arturo182/feather_mimxrt1011/schematics.pdf

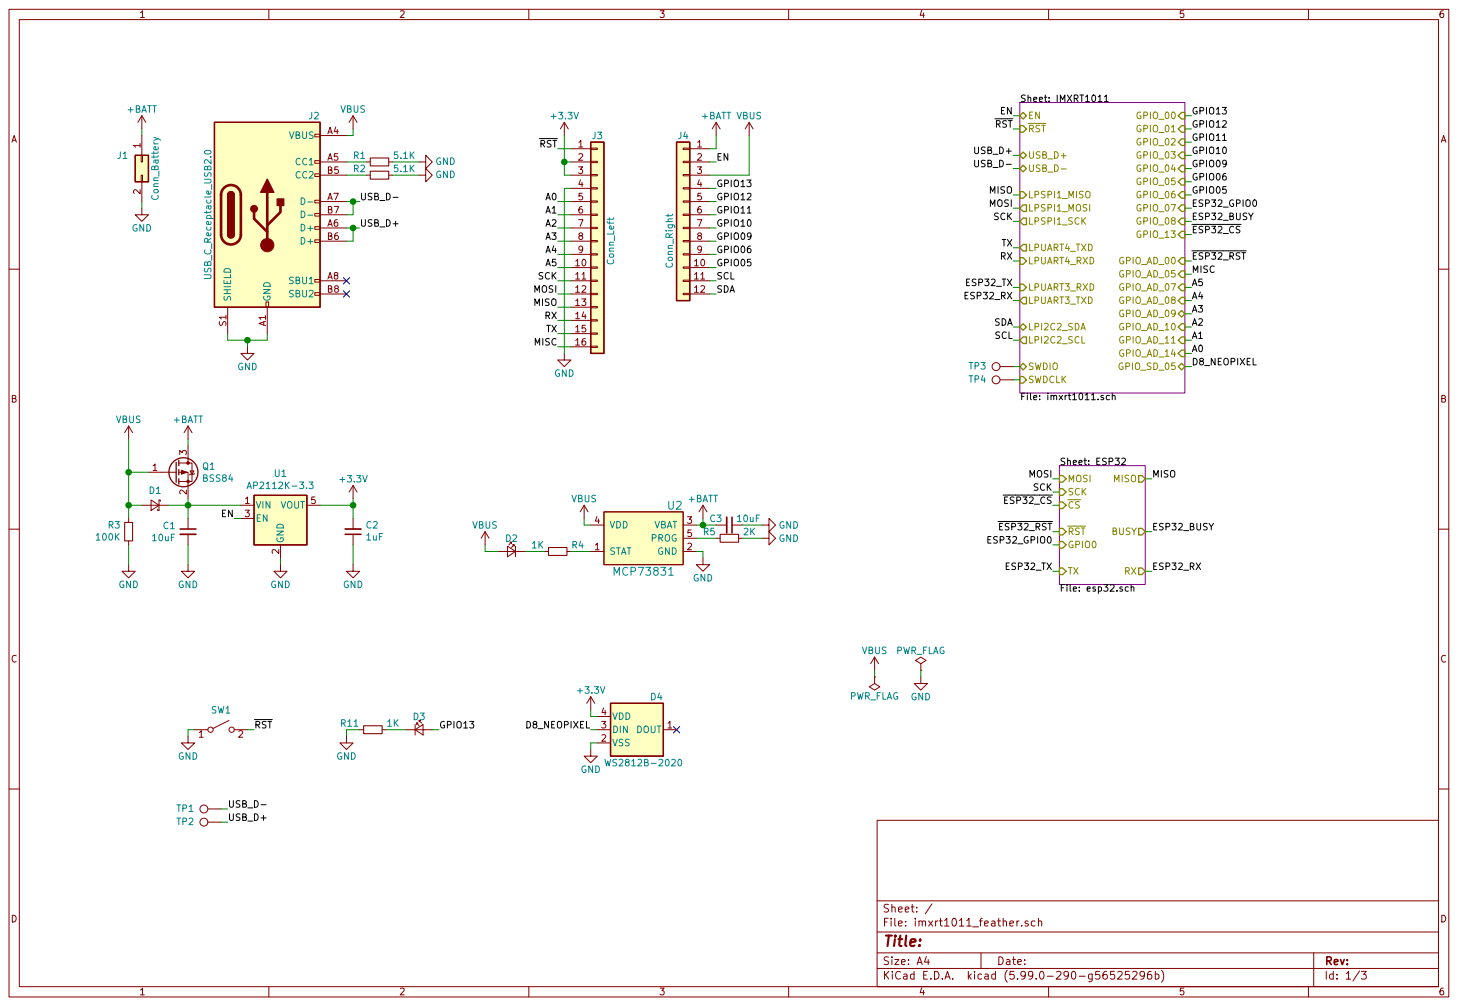
[picture p1: page 1]

ESP32_TX MOSI Sheet: IMXRT1011 File: imxrt1011.sch EN
RST USB_D- USB_D+

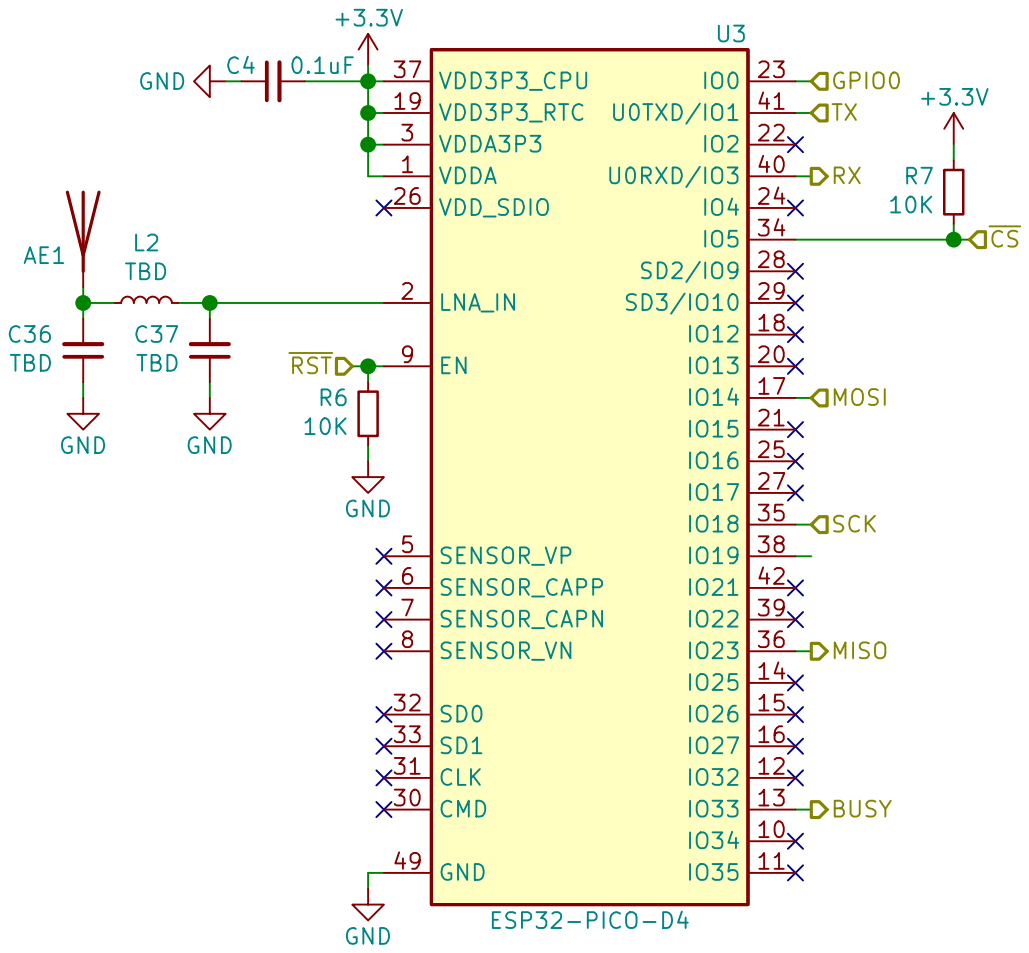
[picture p2: page 2]

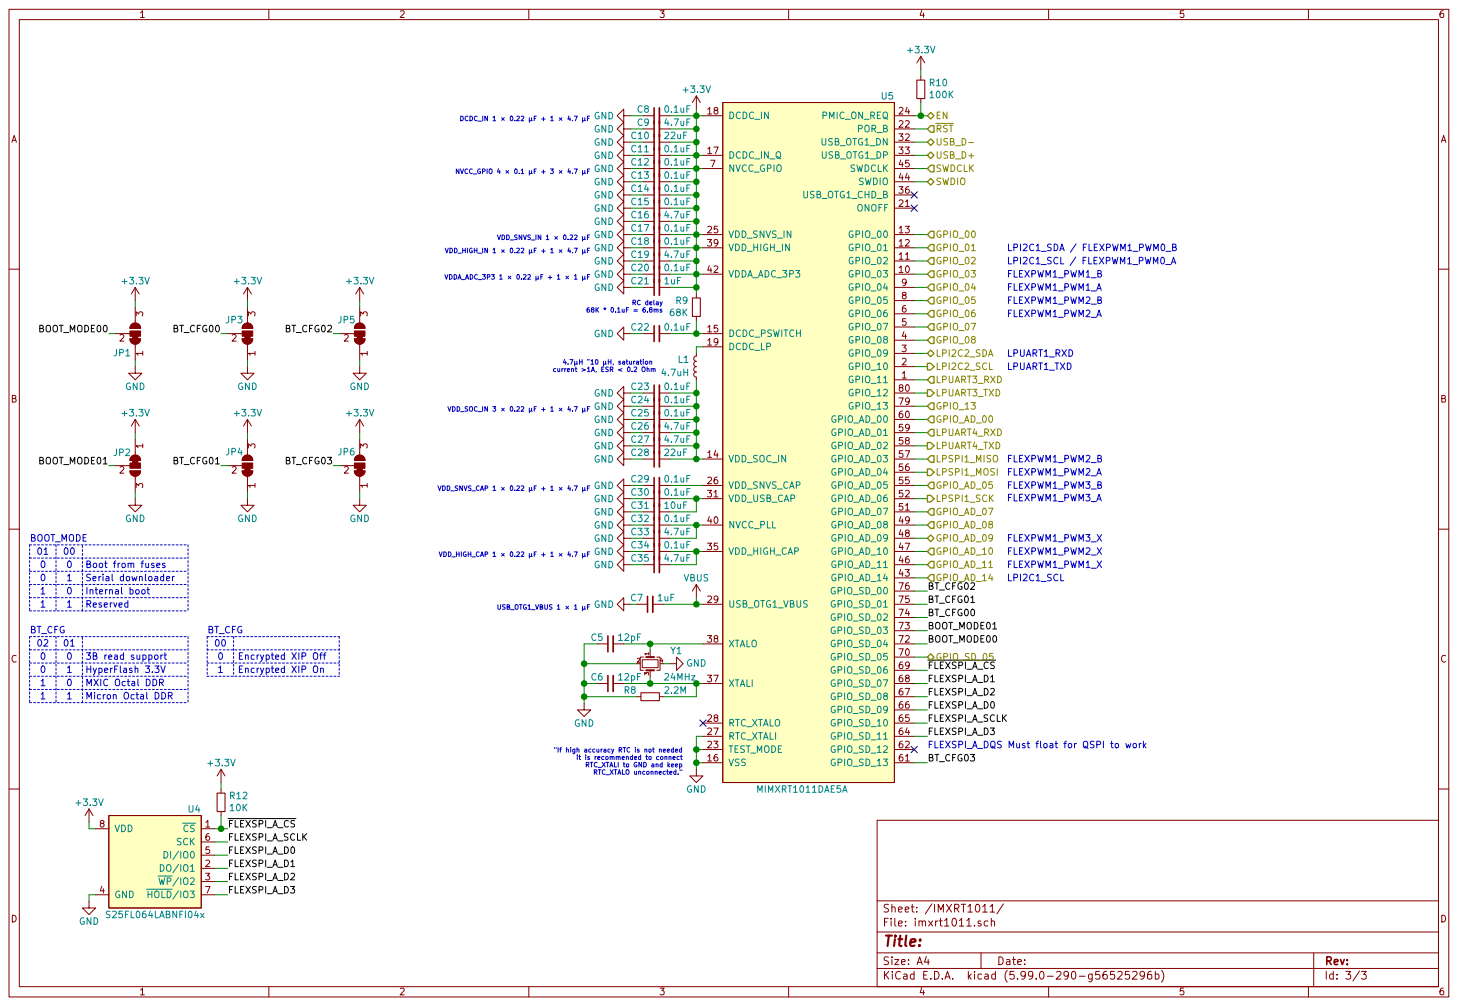
[picture p3: page 3]

it is recommended to connect RTC_XTALI to GND and keep RTC_XTALO unconnected." GND GND

Id: 3/3 Title: File: imxrt1011.sch Sheet: /IMXRT1011/ GND GND GND
FLEXSPI_A_D0 GND GND GND GND GND GND GND

4.7µH 10 µH, saturation current >1A, ESR < 0.2 Ohm

VDD_SOC_IN 3 × 0.22 F + 1 × 4.7 F GND GND GND GND GND GND

FLEXSPI_A_DQS Must float for QSPI to work FLEXSPI_A_CS

"If high accuracy RTC is not needed
