arturo182/feather_mimxrt1011/feather_mimxrt1011.kicad_pcb

## KiCad design feather_mimxrt1011.kicad_pcb (2020-03-11)

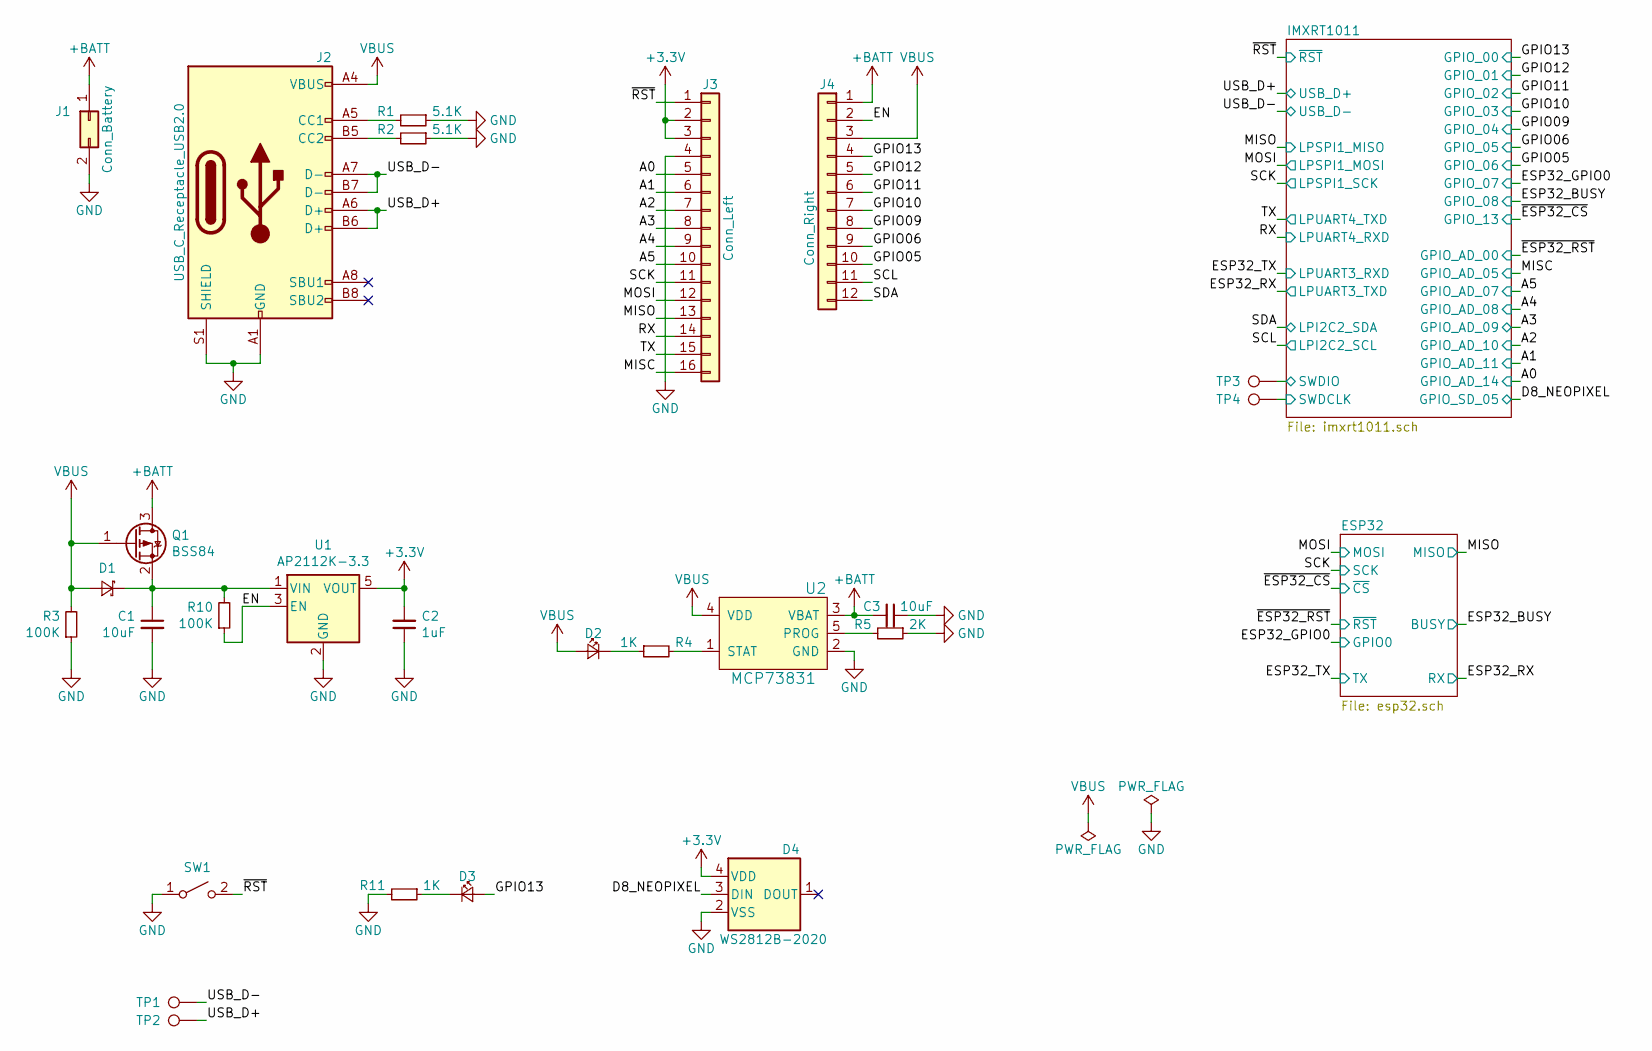
[picture p4: schematic feather_mimxrt1011.sch, Feather MIMXRT1011]

Parts:
C1, C3: 10uF; C_0402_1005Metric
C2: 1uF; C_0402_1005Metric
D1: D_Schottky_Small; D_SOD-323; LCSC C114023
D2: LED_CHR; LED_0603_1608Metric
D3: LED_USR; LED_0603_1608Metric
D4: WS2812B-2020
J1: Conn_Battery; JST_PH_S2B-PH-SM4-TB_1x02-1MP_P2.00mm_Horizontal; LCSC C375128
J2: USB_C_Receptacle_USB2.0; USB_C_Receptacle_HRO_TYPE-C-31-M-12; LCSC C319148
J3: Conn_Left; PinSocket_1x16_P2.54mm_Vertical
J4: Conn_Right; PinSocket_1x12_P2.54mm_Vertical
Q1: BSS84; SOT-23; LCSC C85202
R1, R2: 5.1K; R_0402_1005Metric
R3, R10: 100K; R_0402_1005Metric
R4, R11: 1K; R_0402_1005Metric
R5: 2K; R_0402_1005Metric
SW1: SW_RST; SW_SPST_B3U-1000P-B; LCSC C128937
TP1: TP_USB_D-; TestPoint_Pad_D1.0mm
TP2: TP_USB_D+; TestPoint_Pad_D1.0mm
TP3: TP_SWDIO; TestPoint_Pad_D1.0mm
TP4: TP_SWDCLK; TestPoint_Pad_D1.0mm
U1: AP2112K-3.3; SOT-23-5; LCSC C51118
U2: MCP73831; SOT-23-5; LCSC C14879

Connections:
+3V3: C2.2, D4.4 (VDD), J3.2, J3.3, U1.5 (VOUT); also elsewhere on the board
+BATT: C3.2, J1.1, J4.1, Q1.3 (D), U2.3 (VBAT)
/A0: J3.5; also elsewhere on the board
/A1: J3.6; also elsewhere on the board
/A2: J3.7; also elsewhere on the board
/A3: J3.8; also elsewhere on the board
/A4: J3.9; also elsewhere on the board
/A5: J3.10; also elsewhere on the board
/D8_NEOPIXEL: D4.3 (DIN); also elsewhere on the board
/EN: J4.2, R10.1, U1.3 (EN)
/GPIO05: J4.10; also elsewhere on the board
/GPIO06: J4.9; also elsewhere on the board
/GPIO09: J4.8; also elsewhere on the board
/GPIO10: J4.7; also elsewhere on the board
/GPIO11: J4.6; also elsewhere on the board
/GPIO12: J4.5; also elsewhere on the board
/GPIO13: D3.2 (A), J4.4; also elsewhere on the board
/MISC: J3.16; also elsewhere on the board
/MISO: J3.13; also elsewhere on the board
/MOSI: J3.12; also elsewhere on the board
/RX: J3.14; also elsewhere on the board
/SCK: J3.11; also elsewhere on the board
/SCL: J4.11; also elsewhere on the board
/SDA: J4.12; also elsewhere on the board
/SWDCLK: TP4.1; also elsewhere on the board
/SWDIO: TP3.1; also elsewhere on the board
/TX: J3.15; also elsewhere on the board
/USB_D+: J2.A6 (D+), J2.B6 (D+), TP2.1; also elsewhere on the board
/USB_D-: J2.A7 (D-), J2.B7 (D-), TP1.1; also elsewhere on the board
/~RST~: J3.1, SW1.2 (B); also elsewhere on the board
GND: C1.2, C2.1, C3.1, D4.2 (VSS), J1.2, J2.A1 (GND), J2.A12 (GND), J2.B1 (GND), J2.B12 (GND), J2.S1 (SHIELD), J3.4, R1.1, R2.1, R3.1, R5.1, R11.2, SW1.1 (A), U1.2 (GND), U2.2 (GND); also elsewhere on the board
unnamed: C1.1, D1.1 (K), Q1.2 (S), R10.2, U1.1 (VIN)
unnamed: D2.1 (K), R4.1
unnamed: D3.1 (K), R11.1
unnamed: J2.A5 (CC1), R1.2
unnamed: J2.B5 (CC2), R2.2
unnamed: R4.2, U2.1 (STAT)
unnamed: R5.2, U2.5 (PROG)
VBUS: D1.2 (A), D2.2 (A), J2.A4 (VBUS), J2.A9 (VBUS), J2.B4 (VBUS), J2.B9 (VBUS), J4.3, Q1.1 (G), R3.2, U2.4 (VDD); also elsewhere on the board

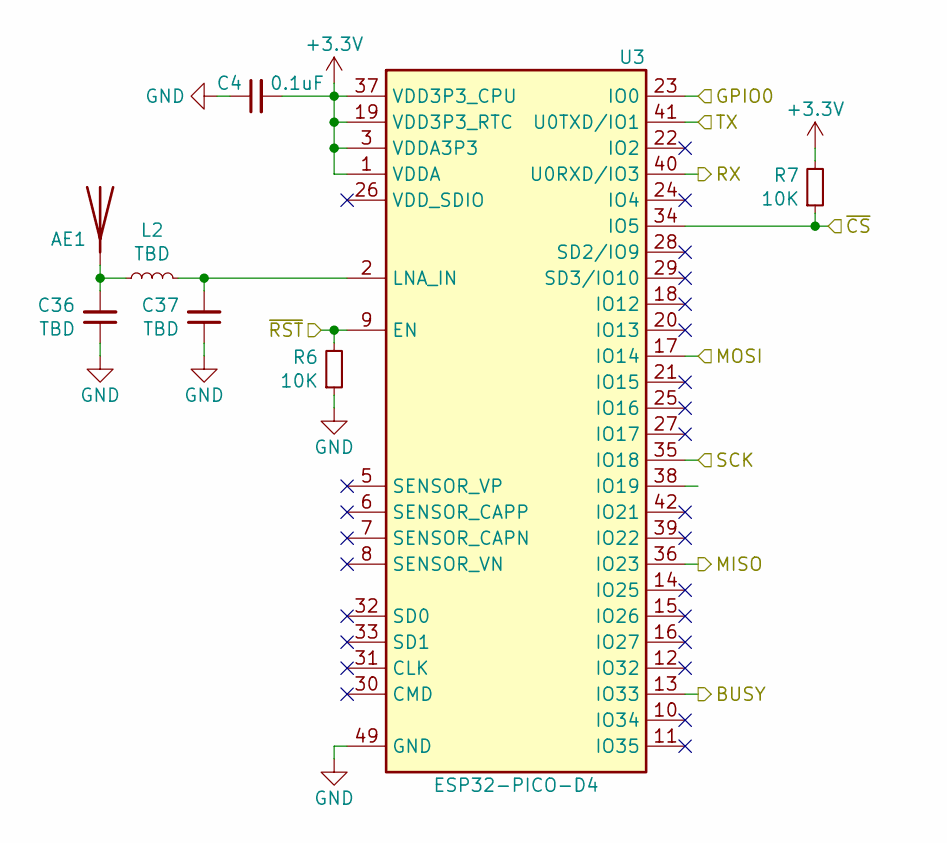
[picture p5: schematic esp32.sch]

Parts:
AE1: 2450AT42B100; Johanson_2450AT42B100; Mouser 609-2450AT42B100E
C4: 0.1uF; C_0402_1005Metric
C36, C37: TBD; C_0402_1005Metric
L2: TBD; L_0402_1005Metric
R6, R7: 10K; R_0402_1005Metric
U3: ESP32-PICO-D4; QFN-48-1EP_7x7mm_P0.5mm_EP5.3x5.3mm; LCSC C193707

Connections:
+3V3: C4.2, R7.2, U3.1 (VDDA), U3.3 (VDDA3P3), U3.4 (VDDA3P3), U3.19 (VDD3P3_RTC), U3.37 (VDD3P3_CPU), U3.43 (VDDA), U3.46 (VDDA); also elsewhere on the board
/ESP32_BUSY: U3.13 (IO33); also elsewhere on the board
/ESP32_GPIO0: U3.23 (IO0); also elsewhere on the board
/ESP32_RX: U3.40 (U0RXD/IO3); also elsewhere on the board
/ESP32_TX: U3.41 (U0TXD/IO1); also elsewhere on the board
/MISO: U3.36 (IO23); also elsewhere on the board
/MOSI: U3.17 (IO14); also elsewhere on the board
/SCK: U3.35 (IO18); also elsewhere on the board
/~ESP32_CS~: R7.1, U3.34 (IO5); also elsewhere on the board
/~ESP32_RST~: R6.2, U3.9 (EN); also elsewhere on the board
GND: C4.1, C36.1, C37.1, R6.1, U3.49 (GND); also elsewhere on the board
unnamed: AE1.1, C36.2, L2.1
unnamed: C37.2, L2.2, U3.2 (LNA_IN)

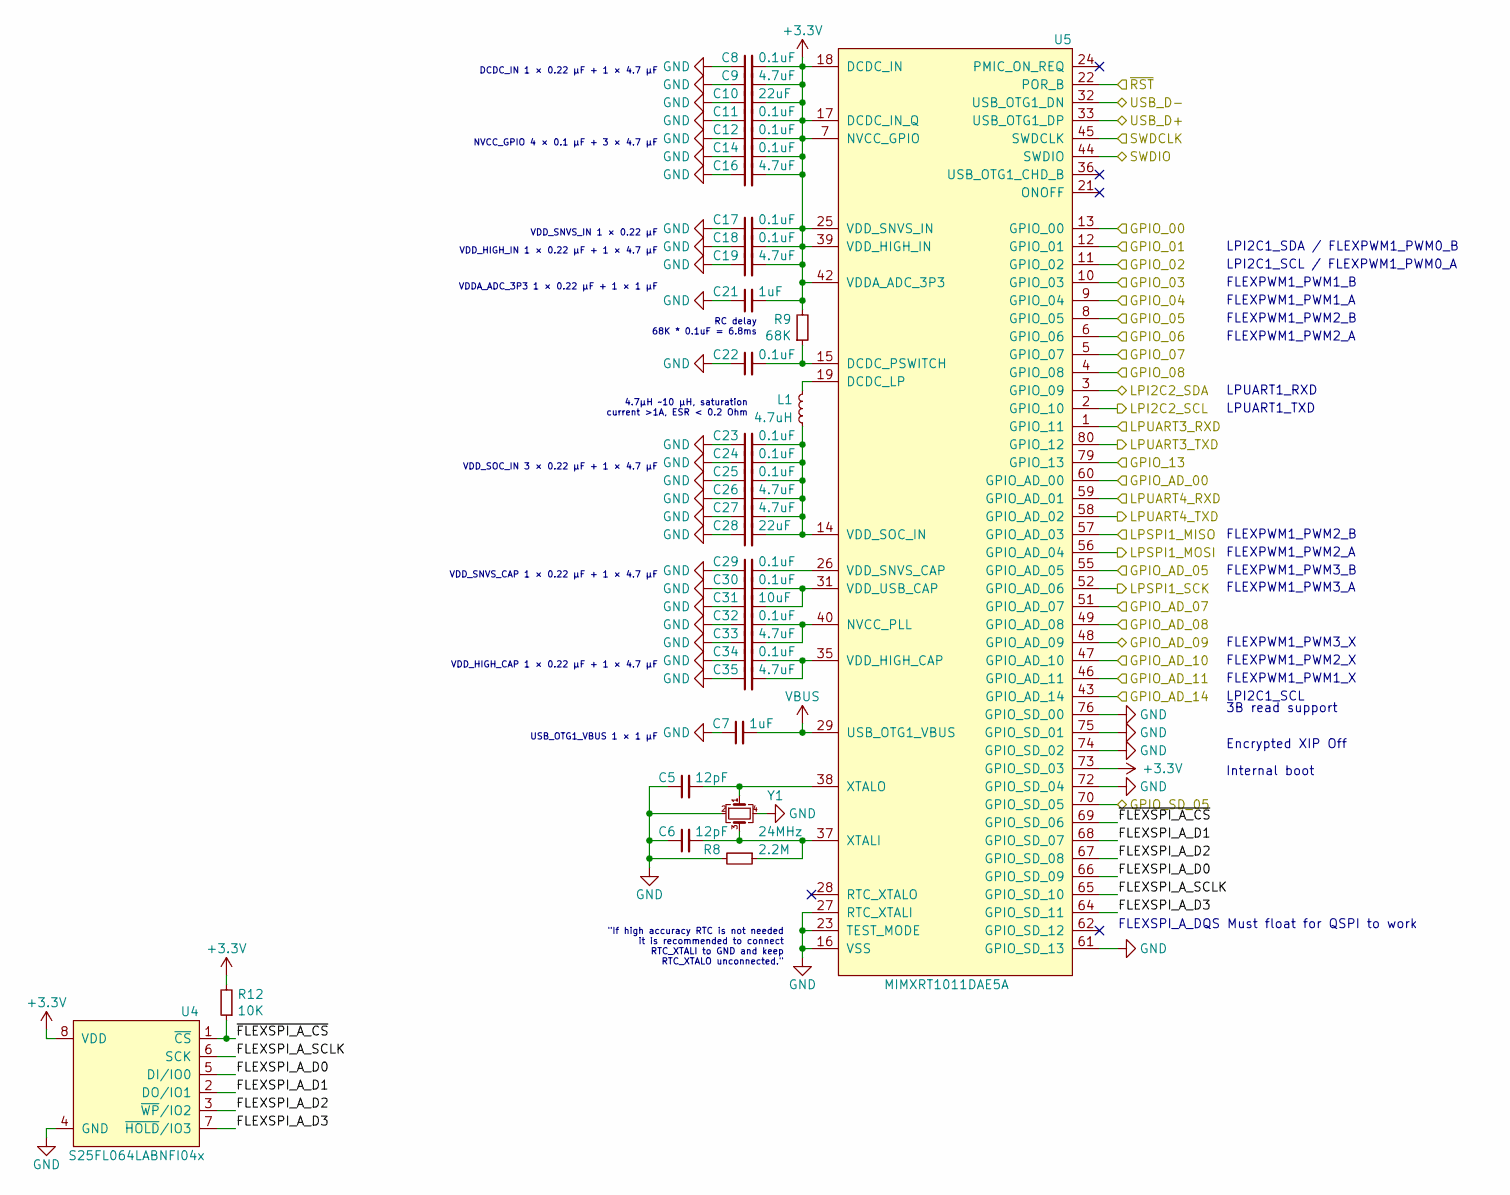
[picture p6: schematic imxrt1011.sch]

Parts:
C5, C6: 12pF; C_0402_1005Metric
C7, C21: 1uF; C_0402_1005Metric
C8, C11, C12, C14, C17, C18, C22, C23, C24, C25, C29, C30, C32, C34: 0.1uF; C_0402_1005Metric
C9, C16, C19, C26, C27, C33, C35: 4.7uF; C_0402_1005Metric
C10, C28: 22uF; C_0603_1608Metric
C31: 10uF; C_0402_1005Metric
L1: 4.7uH; L_0806_2012Metric; LCSC C98036
R8: 2.2M; R_0402_1005Metric
R9: 68K; R_0402_1005Metric
R12: 10K; R_0402_1005Metric
U4: S25FL064LABNFI04x; WSON-8-1EP_6x5mm_P1.27mm_EP3.4x4mm; Mouser 727-S25FL064LABNF040
U5: MIMXRT1011DAE5A; TQFP-80_12x12mm_P0.5mm; Mouser 771-MIMXRT1011DAE5A
Y1: 24MHz; Crystal_SMD_2016-4Pin_2.0x1.6mm; LCSC C389789

Connections:
+3V3: C8.2, C9.2, C10.2, C11.2, C12.2, C14.2, C16.2, C17.2, C18.2, C19.2, C21.2, R9.2, R12.2, U4.8 (VDD), U5.7 (NVCC_GPIO), U5.17 (DCDC_IN_Q), U5.18 (DCDC_IN), U5.25 (VDD_SNVS_IN), U5.39 (VDD_HIGH_IN), U5.42 (VDDA_ADC_3P3), U5.50 (NVCC_GPIO), U5.63 (NVCC_GPIO), U5.71 (NVCC_GPIO), U5.73 (GPIO_SD_03); also elsewhere on the board
/A0: U5.43 (GPIO_AD_14); also elsewhere on the board
/A1: U5.46 (GPIO_AD_11); also elsewhere on the board
/A2: U5.47 (GPIO_AD_10); also elsewhere on the board
/A3: U5.48 (GPIO_AD_09); also elsewhere on the board
/A4: U5.49 (GPIO_AD_08); also elsewhere on the board
/A5: U5.51 (GPIO_AD_07); also elsewhere on the board
/D8_NEOPIXEL: U5.70 (GPIO_SD_05); also elsewhere on the board
/ESP32_BUSY: U5.4 (GPIO_08); also elsewhere on the board
/ESP32_GPIO0: U5.5 (GPIO_07); also elsewhere on the board
/ESP32_RX: U5.80 (GPIO_12); also elsewhere on the board
/ESP32_TX: U5.1 (GPIO_11); also elsewhere on the board
/GPIO05: U5.6 (GPIO_06); also elsewhere on the board
/GPIO06: U5.8 (GPIO_05); also elsewhere on the board
/GPIO09: U5.9 (GPIO_04); also elsewhere on the board
/GPIO10: U5.10 (GPIO_03); also elsewhere on the board
/GPIO11: U5.11 (GPIO_02); also elsewhere on the board
/GPIO12: U5.12 (GPIO_01); also elsewhere on the board
/GPIO13: U5.13 (GPIO_00); also elsewhere on the board
/IMXRT1011/FLEXSPI_A_D0: U4.5 (DI/IO0), U5.66 (GPIO_SD_09)
/IMXRT1011/FLEXSPI_A_D1: U4.2 (DO/IO1), U5.68 (GPIO_SD_07)
/IMXRT1011/FLEXSPI_A_D2: U4.3 (~WP~/IO2), U5.67 (GPIO_SD_08)
/IMXRT1011/FLEXSPI_A_D3: U4.7 (~HOLD~/IO3), U5.64 (GPIO_SD_11)
/IMXRT1011/FLEXSPI_A_SCLK: U4.6 (SCK), U5.65 (GPIO_SD_10)
/IMXRT1011/~FLEXSPI_A_CS~: R12.1, U4.1 (~CS~), U5.69 (GPIO_SD_06)
/MISC: U5.55 (GPIO_AD_05); also elsewhere on the board
/MISO: U5.57 (GPIO_AD_03); also elsewhere on the board
/MOSI: U5.56 (GPIO_AD_04); also elsewhere on the board
/RX: U5.59 (GPIO_AD_01); also elsewhere on the board
/SCK: U5.52 (GPIO_AD_06); also elsewhere on the board
/SCL: U5.2 (GPIO_10); also elsewhere on the board
/SDA: U5.3 (GPIO_09); also elsewhere on the board
/SWDCLK: U5.45 (SWDCLK); also elsewhere on the board
/SWDIO: U5.44 (SWDIO); also elsewhere on the board
/TX: U5.58 (GPIO_AD_02); also elsewhere on the board
/USB_D+: U5.33 (USB_OTG1_DP); also elsewhere on the board
/USB_D-: U5.32 (USB_OTG1_DN); also elsewhere on the board
/~ESP32_CS~: U5.79 (GPIO_13); also elsewhere on the board
/~ESP32_RST~: U5.60 (GPIO_AD_00); also elsewhere on the board
/~RST~: U5.22 (POR_B); also elsewhere on the board
GND: C5.1, C6.1, C7.1, C8.1, C9.1, C10.1, C11.1, C12.1, C14.1, C16.1, C17.1, C18.1, C19.1, C21.1, C22.1, C23.1, C24.1, C25.1, C26.1, C27.1, C28.1, C29.1, C30.1, C31.1, C32.1, C33.1, C34.1, C35.1, R8.2, U4.4 (GND), U4.9 (GND), U5.16 (VSS), U5.20 (DCDC_GND), U5.23 (TEST_MODE), U5.27 (RTC_XTALI), U5.30 (VSS), U5.34 (NGND_KEL0), U5.41 (VSSA_ADC_3P3), U5.54 (VSS), U5.61 (GPIO_SD_13), U5.72 (GPIO_SD_04), U5.74 (GPIO_SD_02), U5.75 (GPIO_SD_01), U5.76 (GPIO_SD_00), U5.78 (VSS), Y1.2, Y1.4; also elsewhere on the board
unnamed: C5.2, U5.38 (XTALO), Y1.1
unnamed: C6.2, R8.1, U5.37 (XTALI), Y1.3
unnamed: C22.2, R9.1, U5.15 (DCDC_PSWITCH)
unnamed: C23.2, C24.2, C25.2, C26.2, C27.2, C28.2, L1.1, U5.14 (VDD_SOC_IN), U5.53 (VDD_SOC_IN), U5.77 (VDD_SOC_IN)
unnamed: C29.2, U5.26 (VDD_SNVS_CAP)
unnamed: C30.2, C31.2, U5.31 (VDD_USB_CAP)
unnamed: C32.2, C33.2, U5.40 (NVCC_PLL)
unnamed: C34.2, C35.2, U5.35 (VDD_HIGH_CAP)
unnamed: L1.2, U5.19 (DCDC_LP)
VBUS: C7.2, U5.29 (USB_OTG1_VBUS); also elsewhere on the board

Notes on the sheet:
VDD_HIGH_IN 1 × 0.22 μF + 1 × 4.7 μF
4.7µH ~~10 µH, saturation current >1A, ESR < 0.2 Ohm
VDD_HIGH_CAP 1 × 0.22 μF + 1 × 4.7 μF
DCDC_IN 1 × 0.22 μF + 1 × 4.7 μF
VDD_SNVS_CAP 1 × 0.22 μF + 1 × 4.7 μF
"If high accuracy RTC is not needed it is recommended to connect RTC_XTALI to GND and keep RTC_XTALO unconnected."
RC delay 68K * 0.1uF = 6.8ms
VDDA_ADC_3P3 1 × 0.22 μF + 1 × 1 μF
NVCC_GPIO 4 × 0.1 μF + 3 × 4.7 μF
VDD_SNVS_IN 1 × 0.22 μF
USB_OTG1_VBUS 1 × 1 μF
FLEXSPI_A_DQS Must float for QSPI to work
VDD_SOC_IN 3 × 0.22 μF + 1 × 4.7 μF
FLEXPWM1_PWM2_A
FLEXPWM1_PWM2_B
FLEXPWM1_PWM3_A
FLEXPWM1_PWM1_X
LPUART1_TXD
FLEXPWM1_PWM1_B
FLEXPWM1_PWM1_A
FLEXPWM1_PWM3_X
FLEXPWM1_PWM2_X
LPI2C1_SCL
FLEXPWM1_PWM3_B
LPI2C1_SDA / FLEXPWM1_PWM0_B
LPI2C1_SCL / FLEXPWM1_PWM0_A
LPUART1_RXD
Internal boot
Encrypted XIP Off
3B read support

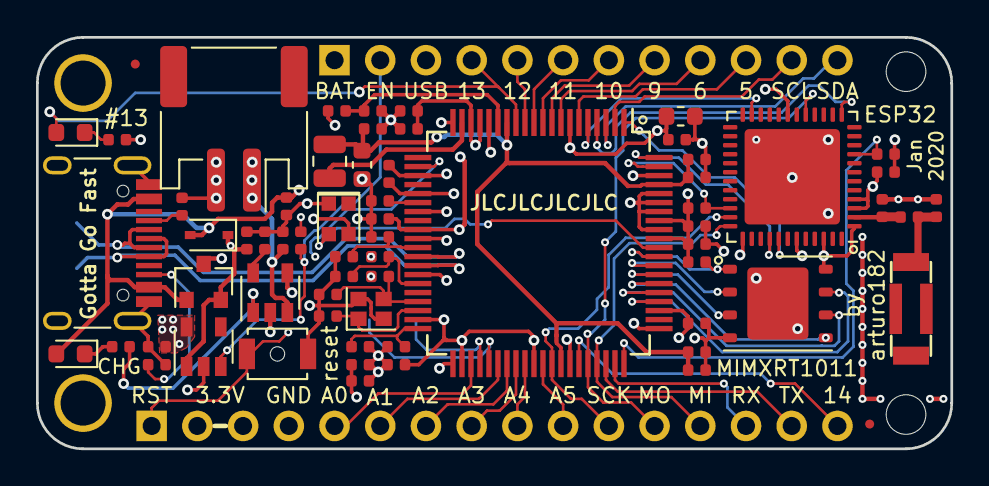
[picture p7: board feather_mimxrt1011.kicad_pcb from above]

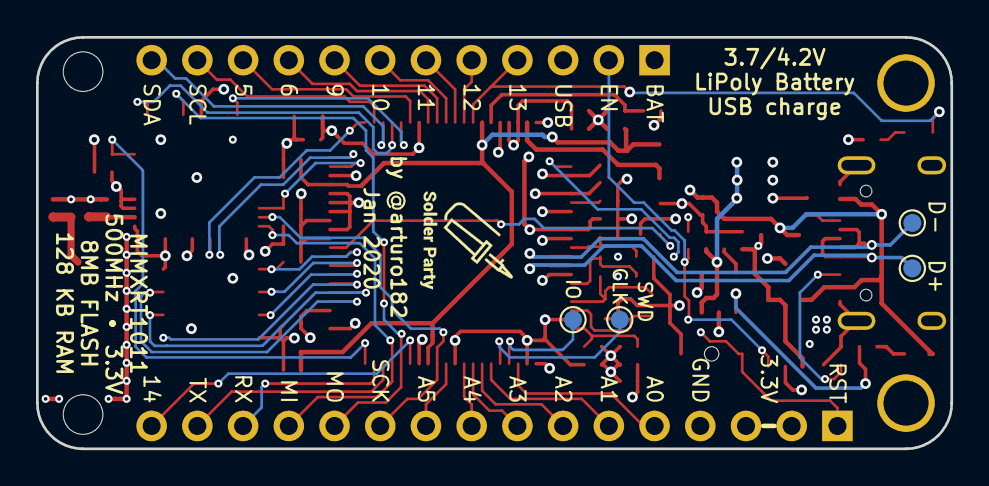
[picture p8: board feather_mimxrt1011.kicad_pcb from below]

Board: 4 copper layers, 50.8 x 22.9 mm, 69 parts (4 on the bottom side), 62 nets.
