arturo182/feather_mimxrt1011/(commit log)

2019-11-04 Initial import
    [imxrt10xx_feather.kicad_pcb, imxrt10xx_feather.sch]
2020-01-10 Rev 1
    [imxrt1011_feather.kicad_pcb]
2020-01-10 Rename to a friendlier project name
    [feather_mimxrt1011.kicad_pcb, feather_mimxrt1011.sch]
2020-03-11 Rev 2
    [esp32.sch, feather_mimxrt1011.kicad_pcb, feather_mimxrt1011.sch, imxrt1011.sch]
